trekawek/mac-plus-ps2/(threads)

Thread 1 (2017-08-22):

Isn't pin 3 reset?

TabajaraLabs, 2017-08-22:
#define PS2_DATA_PIN 3
Isn't that the reset pin on arduino nano?

Also, in the main photo, the wires are clearly attached to different pins. maybe a mistake on source?
Thanks!

trekawek, 2018-09-27:
It's the D3, I've updated the README.md to make it more clear. Sorry for the long response time, I missed the notification.

Closed 2018-09-27.

Thread 2 (2018-09-27):

Where do you put 2 and 6 for the PS/2?

Clodmachine, 2018-09-27:
pin 2 and 6 for the ps2 pinout aren't there

trekawek, 2018-09-27:
These pins are unused. They don't need to be connected to anything.

trekawek, 2018-09-27:
Also, I updated the README.md in ccb9be80b8ae99e5a44bc14f562e2c6dcd3a71d6, so it should be more clear now.

Clodmachine, 2018-09-27:
Great! One more question though. Which audrino is it? I'm hoping to make
this and I can't really tell which one it is.

On Thu, Sep 27, 2018 at 4:12 PM Tomek Rekawek <notifications@github.com>
wrote:

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

trekawek, 2018-09-27:
I think it should work with any Arduino. I created a prototype on Arduino Uno and then the working device on Arduino Uno Nano (to make it more compact).

Clodmachine, 2018-09-27:
Ok, because I saw [this](https://www.ebay.com/itm/MINI-USB-Nano-V3-0-ATmega328P-CH340G-5V-16M-Micro-controller-board-for-Arduino/401592119121) looked like the one in the pic.

Closed 2018-09-27.

Thread 4 (2021-02-17):

The diagram and text describing the pinout conflict each other

mac84tv, 2021-02-17:
I built this project last night and realized that in the "Connecting to Macintosh Plus" text area on this page shows a list of pinouts (for the phone connector side) that are reversed and do not match those in the visual diagram. For example, it says pin 1 is VCC -> Vin, where it should say pin 1 is GND -> GND as shown in the visual diagram.

This is confusing because I was unsure which example to follow and tried connecting my Arduino both ways. Please correct the text to resolve any potential confusion.

For pure newbies, like myself, it may be helpful to mention that the PS/2 connector shown is from the perspective of using a female socket and that pin 1 of the phone jack is on the left (when the wire side is facing toward you).

Thank you for sharing such a wonderful project!

trekawek, 2021-02-20:
Hi @mac84tv!
Thanks! Honestly, getting these diagrams right is the most difficult part of the project. This is another iteration and it still wasn't right/clear. Hopefully it'll be better since c32ef172d6570f611adf270ec51a6aec57859c66 and 417ad73bb89ec6a96e4970e4a3d8206232acf18d.

Thanks for the suggestions, have fun with your Mac Plus!

Regards,
Tomek

Closed 2021-02-20.
